minhcore/dry-storage-cabinet/vi_xu_ly.docx

Tủ bảo quản thiết bị linh kiện chuyên dụng (Đặng Phan Nhật Minh-B2405313)

1. Mô tả nguyên lý hoạt động

-Hệ thống tủ bảo quản hoạt động trên nguyên lý ngưng tụ hơi nước. Cảm biến liên tục đo và giám sát độ ẩm bên trong tủ. Khi độ ẩm vượt quá mức cài đặt, hệ thống tự động kích hoạt module làm lạnh để hạ nhiệt độ luồng khí xuống dưới điểm sương. Hơi nước dư thừa sẽ ngưng tụ thành nước lỏng và được dẫn xả ra ngoài, giúp hạ độ ẩm trong tủ. Khi độ ẩm giảm xuống đạt mức an toàn, hệ thống ngắt module làm lạnh và duy trì trạng thái chờ.

2. Phạm vi thực hiện

Phạm vi:

-Giám sát và hiển thị thông số nhiệt độ, độ ẩm liên tục qua màn hình OLED.

-Cho phép người dùng tùy chỉnh ngưỡng độ ẩm thông qua nút xoay.

-Cảnh báo bằng còi và đèn LED khi độ ẩm hoặc nhiệt độ vượt ngưỡng an toàn.

-Tự động điều chỉnh quá trình hút ẩm bằng module làm lạnh.

Giới hạn:

-Không có cơ chế bù ẩm chủ động.

-Hệ thống chỉ kiểm soát độ ẩm ở mức nhất định.

-Không điều chỉnh được nhiệt độ.

-Phụ thuộc hoàn toàn vào nguồn điện adapter.
