minhcore/dry-storage-cabinet/kicad_project/dry_storage_cabinet_kicad.pdf

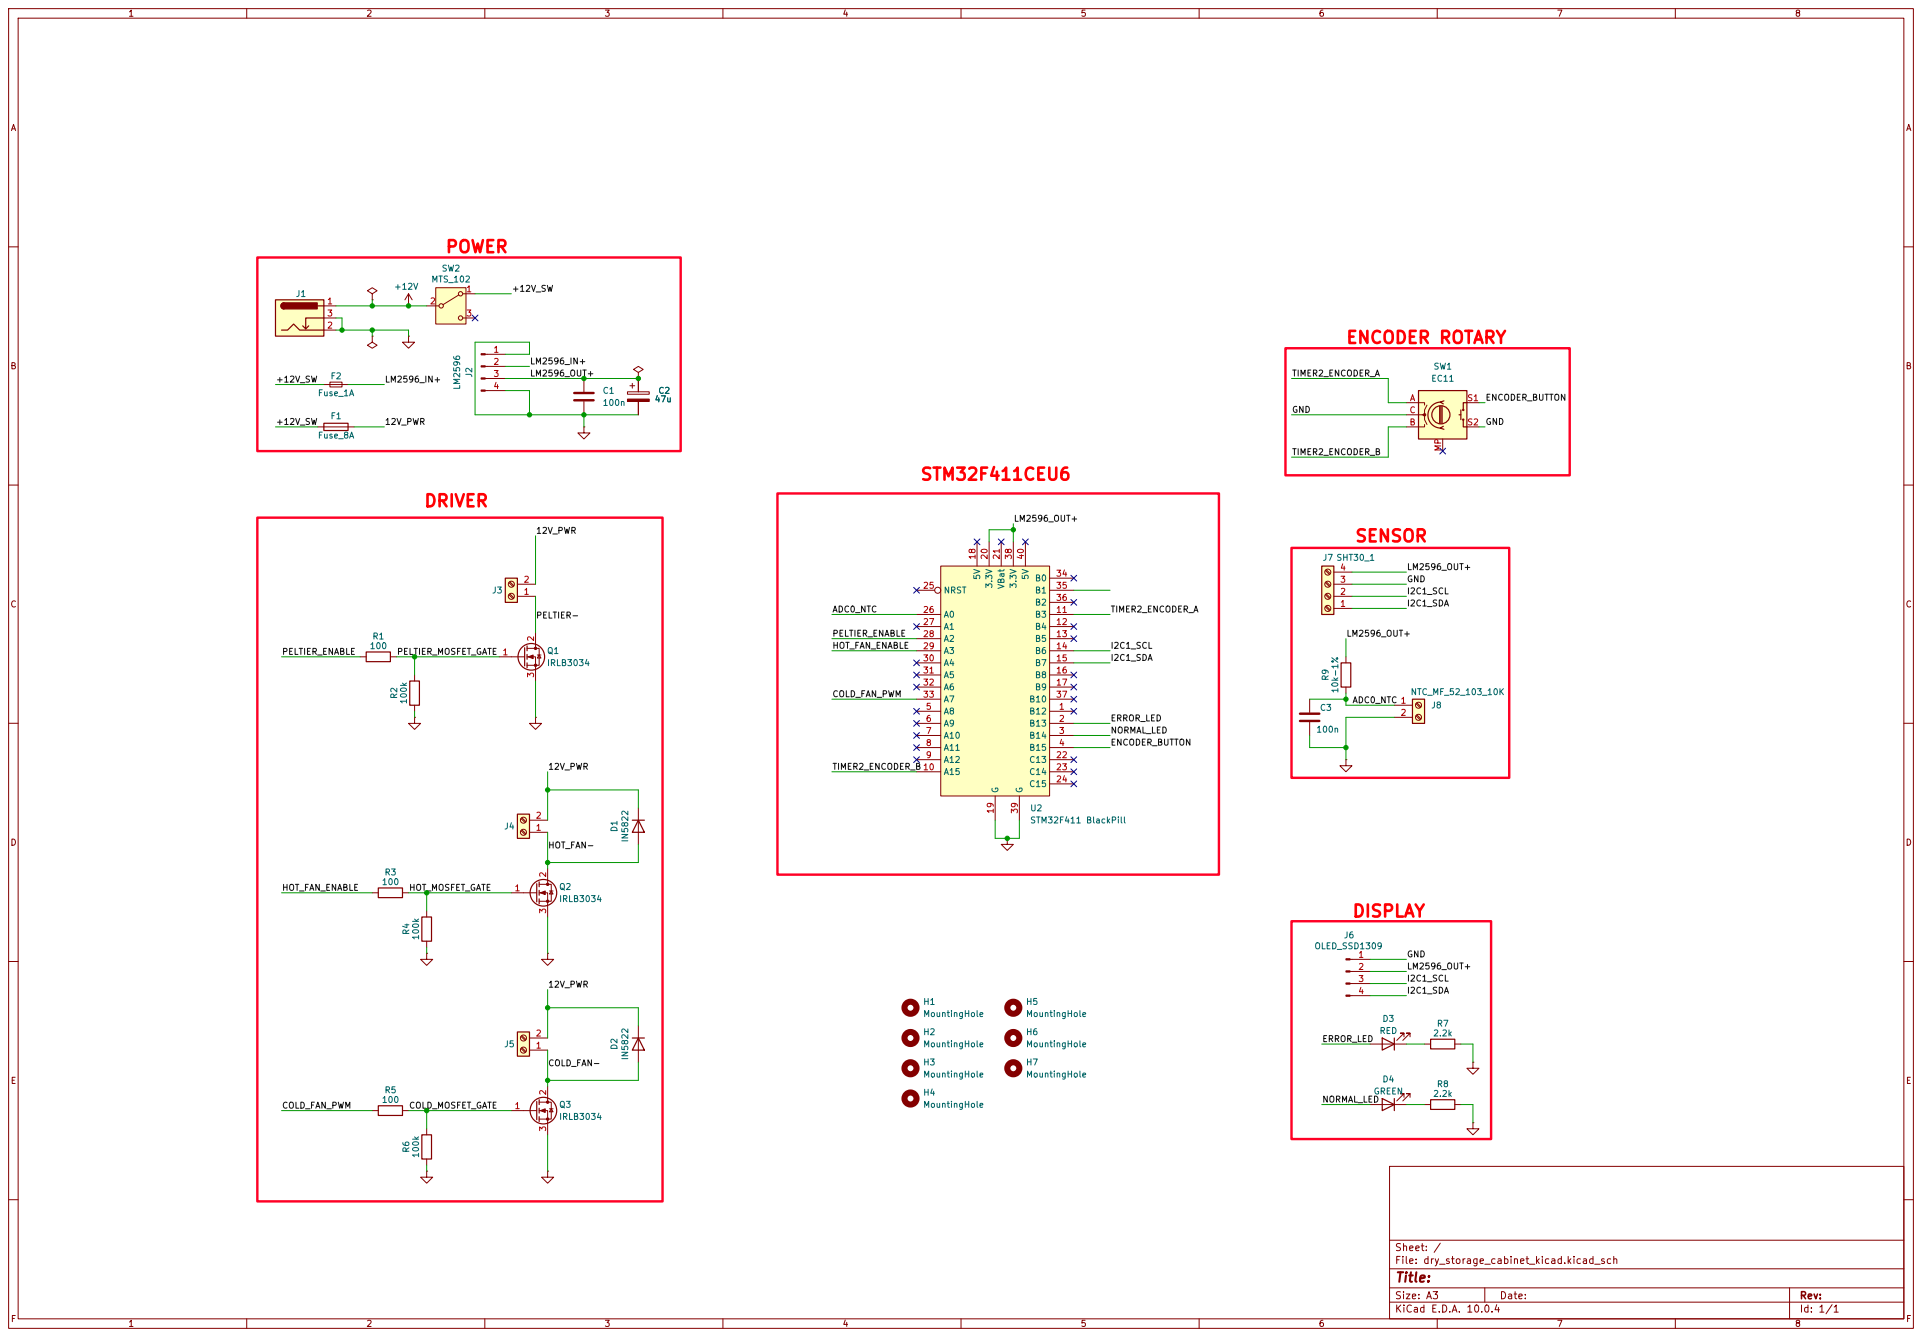
[picture p1: page 1]

Size: A3 | Rev:
KiCad E.D.A. 10.0.4 | Id: 1/1
