minhcore/dry-storage-cabinet/bottom_layer_edge_cut.pdf

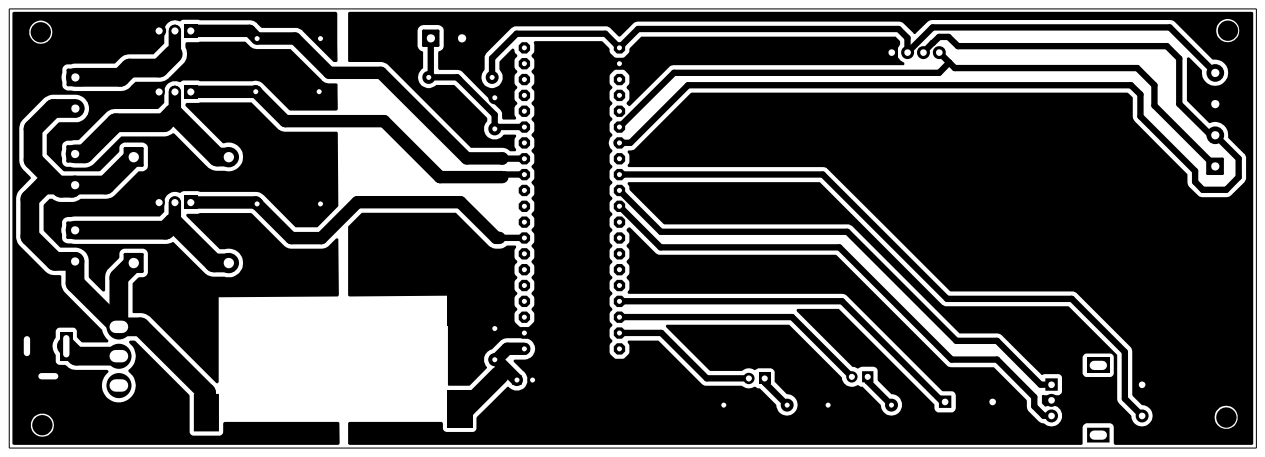
[picture p2: page 1]
