minhcore/dry-storage-cabinet/kicad_project/dry_storage_cabinet_kicad.kicad_pcb

## KiCad design kicad_project/dry_storage_cabinet_kicad.kicad_pcb (2026-07-11)

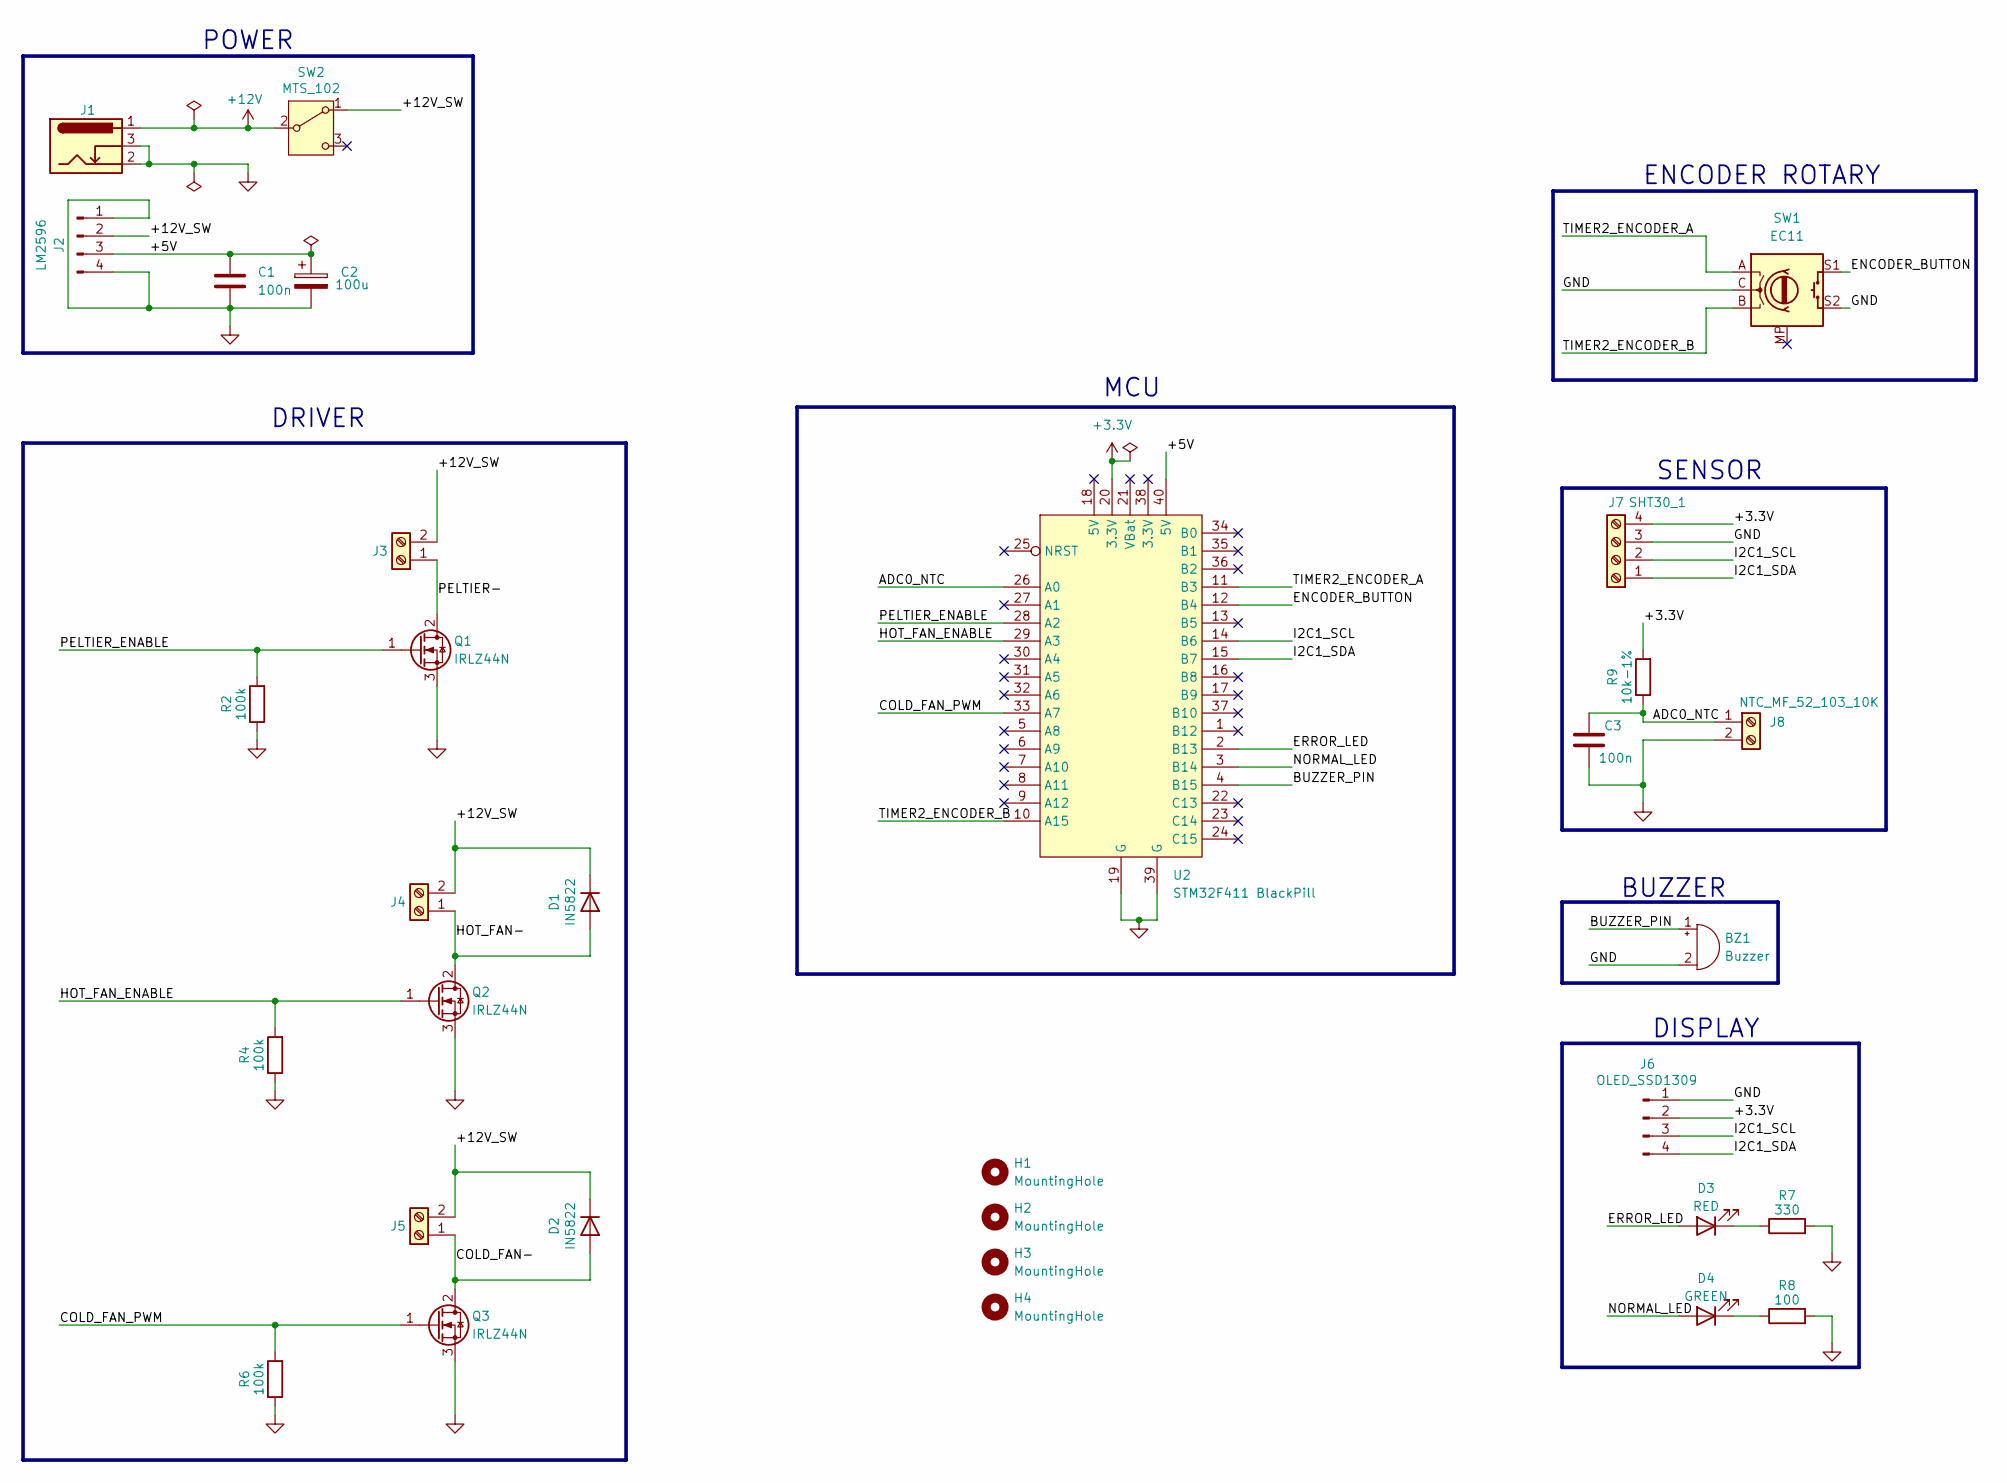
[picture p3: schematic dry_storage_cabinet_kicad.kicad_sch]

Parts:
BZ1: Buzzer; Buzzer_12x9.5RM7.6
C1, C3: 100n; C_Disc_D5.0mm_W2.5mm_P5.00mm
C2: 100u; CP_Radial_D6.3mm_P2.50mm
D1, D2: IN5822; D_DO-201AD_P15.24mm_Horizontal
D3: RED; LED_D3.0mm
D4: GREEN; LED_D3.0mm
H1, H2, H3, H4: MountingHole; MountingHole_3.2mm_M3
J1: Barrel_Jack_Switch; BarrelJack_GCT_DCJ200-10-A_Horizontal
J2: LM2596; LM2596-DC-DC
J3, J4, J5: Screw_Terminal_01x02; TerminalBlock_MaiXu_MX126-5.0-02P_1x02_P5.00mm
J6: OLED_SSD1309; PinHeader_1x04_P2.54mm_Vertical
J7: SHT30_1; TerminalBlock_MaiXu_MX126-5.0-04P_1x04_P5.00mm
J8: NTC_MF_52_103_10K; TerminalBlock_MaiXu_MX126-5.0-02P_1x02_P5.00mm
Q1, Q2, Q3: IRLZ44N; TO-220-3_Vertical
R2, R4, R6: 100k; R_Axial_DIN0207_L6.3mm_D2.5mm_P10.16mm_Horizontal
R7: 330; R_Axial_DIN0207_L6.3mm_D2.5mm_P10.16mm_Horizontal
R8: 100; R_Axial_DIN0207_L6.3mm_D2.5mm_P10.16mm_Horizontal
R9: 10k-1%; R_Axial_DIN0207_L6.3mm_D2.5mm_P10.16mm_Horizontal
SW1: EC11; RotaryEncoder_Alps_EC11E-Switch_Vertical_H20mm_MountingHoles
SW2: MTS_102; MTS102
U2: STM32F411 BlackPill; STM32F411_Black_Pill

Connections:
+3.3V: J6.2, J7.4, R9.2, U2.20 (3.3V)
+12V: J1.1, SW2.2 (B)
/+5V: C1.1, C2.1, J2.3, U2.40 (5V)
/+12V_SW: D1.1 (K), D2.1 (K), J2.2, J3.2, J4.2, J5.2, SW2.1 (A)
/ADC0_NTC: C3.1, J8.1, R9.1, U2.26 (A0)
/BUZZER_PIN: BZ1.1 (+), U2.4 (B15)
/COLD_FAN-: D2.2 (A), J5.1, Q3.2 (D)
/COLD_FAN_PWM: Q3.1 (G), R6.2, U2.33 (A7)
/ENCODER_BUTTON: SW1.S1, U2.12 (B4)
/ERROR_LED: D3.2 (A), U2.2 (B13)
/HOT_FAN-: D1.2 (A), J4.1, Q2.2 (D)
/HOT_FAN_ENABLE: Q2.1 (G), R4.2, U2.29 (A3)
/I2C1_SCL: J6.3, J7.2, U2.14 (B6)
/I2C1_SDA: J6.4, J7.1, U2.15 (B7)
/NORMAL_LED: D4.2 (A), U2.3 (B14)
/PELTIER-: J3.1, Q1.2 (D)
/PELTIER_ENABLE: Q1.1 (G), R2.2, U2.28 (A2)
/TIMER2_ENCODER_A: SW1.A, U2.11 (B3)
/TIMER2_ENCODER_B: SW1.B, U2.10 (A15)
GND: BZ1.2 (-), C1.2, C2.2, C3.2, J1.2, J1.3, J2.1, J2.4, J6.1, J7.3, J8.2, Q1.3 (S), Q2.3 (S), Q3.3 (S), R2.1, R4.1, R6.1, R7.2, R8.2, SW1.C, SW1.S2, U2.19 (G), U2.39 (G)
unnamed: D3.1 (K), R7.1
unnamed: D4.1 (K), R8.1

Notes on the sheet:
BUZZER
DRIVER
ENCODER ROTARY
POWER
DISPLAY
MCU
SENSOR

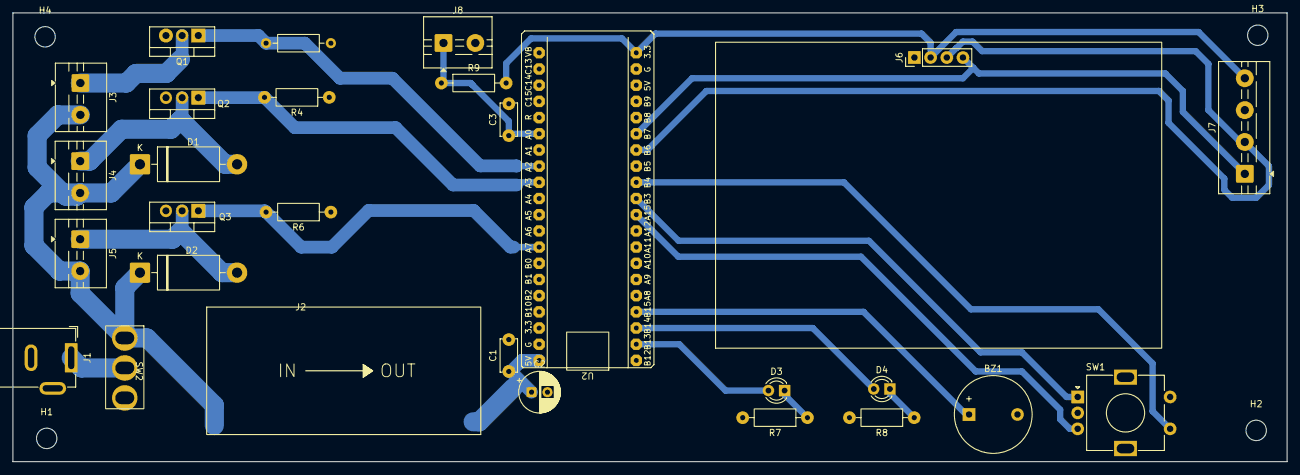
[picture p4: board dry_storage_cabinet_kicad.kicad_pcb from above]

Board: 2 copper layers, 199.9 x 70.4 mm, 32 parts (0 on the bottom side), 22 nets.
