minhcore/dry-storage-cabinet/kicad_project/sht30_pin_to_terminal/sht30_pin_to_terminal.kicad_pcb

## KiCad design kicad_project/sht30_pin_to_terminal/sht30_pin_to_terminal.kicad_pcb (2026-06-30)

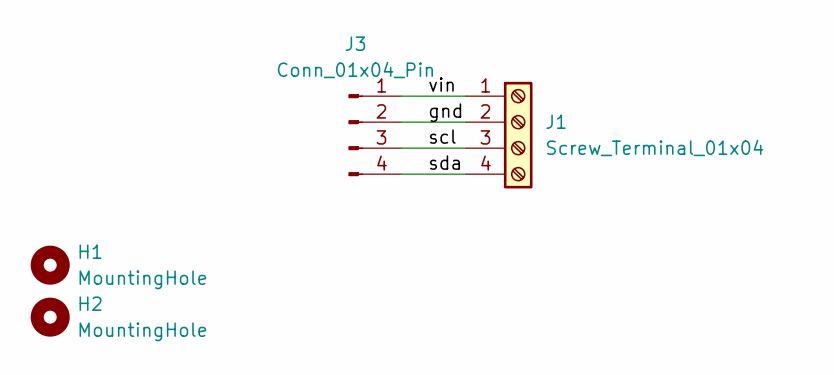
[picture p5: schematic sht30_pin_to_terminal.kicad_sch]

Parts:
H1, H2: MountingHole; MountingHole_3.2mm_M3
J1: Screw_Terminal_01x04; TerminalBlock_MaiXu_MX126-5.0-04P_1x04_P5.00mm
J3: Conn_01x04_Pin; PinHeader_1x04_P2.54mm_Vertical

Connections:
/gnd: J1.2, J3.2
/scl: J1.3, J3.3
/sda: J1.4, J3.4
/vin: J1.1, J3.1

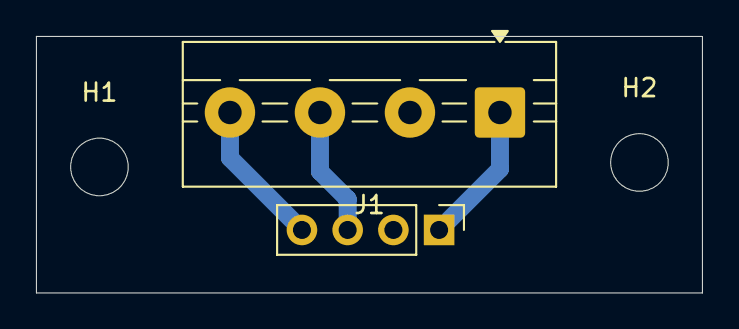
[picture p6: board sht30_pin_to_terminal.kicad_pcb from above]

Board: 2 copper layers, 37.0 x 14.2 mm, 4 parts (0 on the bottom side), 4 nets.
