minhcore/dry-storage-cabinet/stm32f411ceu6_ide_project/Core/Src/main.c

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
/* Includes ------------------------------------------------------------------*/
#include "main.h"

/* USER CODE BEGIN Includes */
#include "oled.h"
#include "sht30.h"
#include "ntc.h"
#include "encoder.h"
#include "control.h"
#include "display.h"
#include "fsm.h"
#include "uart.h"
/* USER CODE END Includes */

/* USER CODE BEGIN PD */
#define STATUS_PORT 				GPIOB
#define ERROR_LED_PIN 				GPIO_PIN_13
#define PELTIER_LED_PIN 			GPIO_PIN_14
#define BUZZER_PIN 					GPIO_PIN_15

#define DRIVER_PORT					GPIOA
#define PELTIER_PIN 				GPIO_PIN_2
#define HOT_FAN_PIN 				GPIO_PIN_3

#define COLD_FAN_TIM_HANDLE			&htim3
#define COLD_FAN_CHANNEL 			TIM_CHANNEL_2

#define ENCODER_BUTTON_PIN			GPIO_PIN_4
#define ENCODER_MAIN_TIM_HANDLE		&htim2
#define ENCODER_TICK_TIM_HANDLE		&htim4

#define MAX_SENSOR_ERROR 			5
#define MAX_DISPLAY_ERROR 			10
/* USER CODE END PD */

ADC_HandleTypeDef hadc1;

I2C_HandleTypeDef hi2c1;

TIM_HandleTypeDef htim2;
TIM_HandleTypeDef htim3;
TIM_HandleTypeDef htim4;

UART_HandleTypeDef huart1;

/* USER CODE BEGIN PV */
oled_t oled = {0};
sht30_t sht30 = {0};
ntc_t ntc = {0};
encoder_t encoder = {0};
control_t control = {0};
volatile event_e event;
state_e current_state;
event_e local_event;
uint8_t sensor_error = 0;
uint8_t display_error = 0;
uint32_t oled_tick = 0;
uint32_t sensor_tick = 0;
uint32_t uart_tick = 0;
uint32_t error_tick, hot_fan_timeout;
sht30_status_e sht30_status;
ntc_status_e ntc_status;
oled_status_e oled_status;
volatile bool error_pending = false;
/* USER CODE END PV */

void SystemClock_Config(void);
static void MX_GPIO_Init(void);
static void MX_ADC1_Init(void);
static void MX_I2C1_Init(void);
static void MX_TIM2_Init(void);
static void MX_TIM3_Init(void);
static void MX_TIM4_Init(void);
static void MX_USART1_UART_Init(void);
/* USER CODE BEGIN 0 */
void HAL_GPIO_EXTI_Callback(uint16_t GPIO_Pin)
{
	if (GPIO_Pin == encoder.button_pin) // Encoder Button is pressed
	{
		if ((HAL_GetTick() - encoder.debounce_tick) >= 200)
		{
			encoder.is_pressed_button = 1;
			encoder.debounce_tick = HAL_GetTick();
		}
	}
}

void HAL_TIM_PeriodElapsedCallback(TIM_HandleTypeDef* htim)
{
	if (htim == &htim4)
	{
		encoder_read(&encoder);
		switch(encoder.status)
		{
		case ENCODER_SCROLL_UP:
			event = UP;
			break;
		case ENCODER_SCROLL_DOWN:
			event = DOWN;
			break;
		case ENCODER_PRESSED:
			event = PRESSED;
			break;
		case ENCODER_NONE:
			break;
		}
	}
}

void menu_setting(void)
{
	switch (current_state)
	{
	case SET_HUM_CHOOSE:
		if (local_event == UP) 	control.target_hum = (control.target_hum == 60) ? 60 : control.target_hum + 1;
		else if (local_event == DOWN) control.target_hum = (control.target_hum == 35) ? 35 : control.target_hum - 1;
		break;
	case SET_ALARM_BUZZER_CHOOSE:
		if (local_event == UP) control.is_buzzer = true;
		else if (local_event == DOWN) control.is_buzzer = false;
		break;
	case SET_ALARM_LIMIT_TEMP_CHOOSE:
		if (local_event == UP) control.temp_limit = (control.temp_limit == 100) ? 100 : control.temp_limit + 1;
		else if (local_event == DOWN) control.temp_limit = (control.temp_limit == 0) ? 0 : control.temp_limit - 1;
		break;
	case SET_ALARM_MARGIN_HUM_CHOOSE:
		if (local_event == UP) control.hum_margin = (control.hum_margin == 10) ? 10 : control.hum_margin + 1;
		else if (local_event == DOWN) control.hum_margin = (control.hum_margin == 0) ? 0 : control.hum_margin - 1;
		break;
	case SET_ALARM_DELAY_HUM_CHOOSE:
		if (local_event == UP) control.hum_delay_mins = (control.hum_delay_mins == 120) ? 120 : control.hum_delay_mins + 5;
		else if (local_event == DOWN) control.hum_delay_mins = (control.hum_delay_mins == 0) ? 0 : control.hum_delay_mins - 5;
		break;
	default: break;
	}
}

void error_raise(void)
{
	if (error_pending) return;

	error_pending = true;
	error_tick = HAL_GetTick();
	hot_fan_timeout = HAL_GetTick();

	// stop all the loads except Hot Fan, leave it to cool down Peltier
	HAL_GPIO_WritePin(DRIVER_PORT, PELTIER_PIN, 0);
	HAL_TIM_PWM_Stop(COLD_FAN_TIM_HANDLE, COLD_FAN_CHANNEL);
	HAL_GPIO_WritePin(STATUS_PORT, BUZZER_PIN, 0);
	HAL_GPIO_WritePin(STATUS_PORT, PELTIER_LED_PIN, 0);
	HAL_GPIO_WritePin(DRIVER_PORT, HOT_FAN_PIN, 1);
}

void error_task(void)
{
	if (!error_pending) return;

	if ((HAL_GetTick() - error_tick) >= 500)
	{
		HAL_GPIO_TogglePin(STATUS_PORT, ERROR_LED_PIN);
		error_tick = HAL_GetTick();
	}

	// After 1 minutes of error happening, turn off Hot Fan
	if ((HAL_GetTick() - hot_fan_timeout) >= 60000) HAL_GPIO_WritePin(DRIVER_PORT, HOT_FAN_PIN, 0);
}

void menu_task(void)
{
	__disable_irq();
	local_event = event;
	event = NONE;
	__enable_irq();

	state_e state_before_event = fsm_get();

	if ((state_before_event == RUNNING) && (local_event == PRESSED) && (control.is_alarm_hum || control.is_alarm_temp))
	{
		control_alarm_ack(&control);
		local_event = NONE; // overwrite if has ALARM
	}

	if (error_pending) local_event = ERROR_HAPPEN; // overwrite if has ERROR

	fsm_run(local_event);
	current_state = fsm_get();
	menu_setting();
}

// Because OLED using i2c interrupt so need this function to call error_raise() task
void HAL_I2C_ErrorCallback(I2C_HandleTypeDef *hi2c)
{
	if (oled.i2c == hi2c)
	{
		display_error++;
		if (display_error >= MAX_DISPLAY_ERROR) error_raise();
	}
}

/* USER CODE END 0 */

/**
  * @brief  The application entry point.
  * @retval int
  */
int main(void)
{

  /* MCU Configuration--------------------------------------------------------*/

  /* Reset of all peripherals, Initializes the Flash interface and the Systick. */
  HAL_Init();

  /* Configure the system clock */
  SystemClock_Config();

  /* Initialize all configured peripherals */
  MX_GPIO_Init();
  MX_ADC1_Init();
  MX_I2C1_Init();
  MX_TIM2_Init();
  MX_TIM3_Init();
  MX_TIM4_Init();
  MX_USART1_UART_Init();
  /* USER CODE BEGIN 2 */

  // OLED
  oled_status = oled_init(&oled, &hi2c1, OLED_ADDR);
  if (oled_status != OLED_OK) error_raise();
  //

  // SHT30
  sht30_status = sht30_init(&sht30, &hi2c1, SHT30_ADDR, sht30_high_repeatability_mode);
  if (sht30_status != SHT30_OK) error_raise();
  //

  // NTC
  ntc_init(&ntc, &hadc1);
  //

  // ENCODER EC11
  encoder_init(&encoder, ENCODER_MAIN_TIM_HANDLE, ENCODER_BUTTON_PIN);
  HAL_TIM_Base_Start_IT(ENCODER_TICK_TIM_HANDLE);
  //

  // POWER DRIVER
  control_init(&control, COLD_FAN_TIM_HANDLE, COLD_FAN_CHANNEL,
		  DRIVER_PORT, PELTIER_PIN, DRIVER_PORT, HOT_FAN_PIN,
		  STATUS_PORT, PELTIER_LED_PIN, STATUS_PORT, BUZZER_PIN);
  //

  // FSM INIT
  fsm_init();
  //

  oled_clear_display(&oled);
  oled_status = oled_send_buffer(&oled);
  if (oled_status != OLED_OK) display_error++;
  /* USER CODE END 2 */

  /* Infinite loop */
  /* USER CODE BEGIN WHILE */
  while (1)
  {
	  menu_task(); // Update current state

	  error_task(); // Handle error

	  if (!error_pending)
	  {
		  control_buzzer_update(&control); // Update buzzer state

		  // Reading sensor values -> Checking alarm and Updating control state
		  if (((HAL_GetTick() - sensor_tick) >= 500) && (HAL_I2C_GetState(sht30.i2c)) == HAL_I2C_STATE_READY)
		  {
			  sht30_status = sht30_get(&sht30);
			  ntc_status = ntc_read_adc(&ntc);

			  if ((sht30_status == SHT30_OK) && (ntc_status == NTC_OK))
			  {
				  sht30_calculate(&sht30);
				  ntc_calculate_temp(&ntc);

				  control_alarm_hum_check(&control, &sht30);
				  control_alarm_temp_check(&control, &sht30);
				  control_update(&control, &ntc, &sht30);

				  sensor_error = 0; // reset sensor error when sht30 and ntc read OK
			  }
			  else
			  {
				  sensor_error++;
				  if (sensor_error >= MAX_SENSOR_ERROR) error_raise();
			  }

			  sensor_tick = HAL_GetTick();
		  }
	  }

	  // Displaying on OLED
	  if ((HAL_GetTick() - oled_tick) >= 250 && (HAL_I2C_GetState(oled.i2c)) == HAL_I2C_STATE_READY)
	  {
		  display_update(current_state, &oled, &sht30, &control);
		  oled_status = oled_send_buffer(&oled);

		  if (oled_status == OLED_OK)
		  {
			  display_error = 0; // reset display error when oled displays OK
		  }
		  else
		  {
			  display_error++;
			  if (display_error >= MAX_DISPLAY_ERROR) error_raise();
		  }

		  oled_tick = HAL_GetTick();
	  }

	  if ((HAL_GetTick() - uart_tick) >= 500)
	  {
		  uart_send_int(HAL_GetTick());
		  uart_send_char(',');
		  uart_send_int(sht30.hum*100);
		  uart_send_char(',');
		  uart_send_int(control.target_hum*100);
		  uart_send_char(',');
		  uart_send_int(control.debug_turn_on*100);
		  uart_send_char(',');
		  uart_send_int(control.debug_turn_off*100);
		  uart_send_char(',');
		  uart_send_int(control.debug_peltier);
		  uart_send_char(',');
		  uart_send_int(control.debug_cold_fan);
		  uart_send_char(',');
		  uart_send_int(ntc.temp*100);
		  uart_send_char(',');
		  uart_send_int(control.debug_dewpoint*100);
		  uart_send_char(',');
		  uart_send_int(control.state_elapsed_ms);
		  uart_send_char(',');
		  uart_send_int(control.debug_profile);
		  uart_send_char(',');
		  uart_send_int(control.debug_condensing_started);
		  uart_send_char(',');
		  uart_send_int(control.debug_fan_boost_allowed);
		  uart_send_char(',');
		  uart_send_int(sht30.temp*100);
		  uart_send_string("\r\n");
		  uart_tick = HAL_GetTick();
	  }
	  /* USER CODE END WHILE */

    /* USER CODE BEGIN 3 */
  }
  /* USER CODE END 3 */
}

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
