minhcore/dry-storage-cabinet/stm32f411ceu6_ide_project/stm32f411ceu6_final_project.ioc

Mcu.UserName=STM32F411CEUx
PA0-WKUP.Signal=ADCx_IN0
PA10.Signal=USART1_RX
PA15.Signal=S_TIM2_CH1_ETR
PA2.Signal=GPIO_Output
PA3.Signal=GPIO_Output
PA7.Signal=S_TIM3_CH2
PA9.Signal=USART1_TX
PB13.Signal=GPIO_Output
PB14.Signal=GPIO_Output
PB15.Signal=GPIO_Output
PB3.Signal=S_TIM2_CH2
PB4.Signal=GPXTI4
PB6.Signal=I2C1_SCL
PB7.Signal=I2C1_SDA
