minhcore/dry-storage-cabinet/stm32f411ceu6_ide_project/Core/Inc/fsm.h

#ifndef FSM_H_
#define FSM_H_

typedef enum
{
	// Main state
	RUNNING,
	ERROR_HANDLE,

	// Menu setting state
	SET_TARGET,
	SET_ALARM,
	MENU_EXIT,

	// Humidity setting state
	SET_HUM_IDLE,
	SET_HUM_CHOOSE,
	SET_HUM_BACK,

	// Set Alarm (MAIN) setting state
	SET_ALARM_TEMP,
	SET_ALARM_HUM,
	SET_ALARM_BUZZER,
	SET_ALARM_BUZZER_CHOOSE,
	SET_ALARM_BACK,
	
	// Set Alarm (SUB) temperature
	SET_ALARM_LIMIT_TEMP,
	SET_ALARM_LIMIT_TEMP_CHOOSE,
	SET_ALARM_TEMP_BACK,

	// Set Alarm (SUB) humidity
	SET_ALARM_MARGIN_HUM,
	SET_ALARM_MARGIN_HUM_CHOOSE,
	SET_ALARM_DELAY_HUM,
	SET_ALARM_DELAY_HUM_CHOOSE,
	SET_ALARM_HUM_BACK

	// ...
} state_e;
typedef enum
{
	UP,
	DOWN,
	PRESSED,
	NONE,
	ERROR_HAPPEN
} event_e;

typedef struct
{
	state_e current_state;
	event_e event;
	state_e next_state;
} transition_t;

void fsm_init(void);
void fsm_run(event_e current_event);
state_e fsm_get(void);

#endif
