minhcore/dry-storage-cabinet/(commit log)

2026-06-23 create basic folder for kicad
    [dry_storage_cabinet_kicad.kicad_pcb, dry_storage_cabinet_kicad.kicad_sch]
2026-06-24 Testing oled driver & encoder driver
2026-06-30 Get ready to testing i2c 20 cm cable
    [sht30_pin_to_terminal.kicad_pcb, sht30_pin_to_terminal.kicad_sch]
2026-07-11 70% hardware, testing now
    [dry_storage_cabinet_kicad.kicad_pcb, dry_storage_cabinet_kicad.kicad_sch]
2026-07-12 all the driver are good, get ready to refractor code
2026-07-12 done the fsm using table method, kinda good, I feel it better than nested switch
2026-07-13 Fixed the smooth of encoder and display, update encoder.c and oled.c
    [display.c, encoder.c, fsm.c, fsm.h, main.c, oled.c, sht30.c, stm32f411ceu6_final_project.ioc]
2026-07-13 Create some menu display and new logic for control humidity using D in PID
2026-08-02 new logic for control Peltier, derivatives is a little bit noisy
    [log_40.csv, log_50.csv, log_50_with_peak_tracking.csv, log_50_with_peak_tracking_learn.csv, log_60.csv]
2026-08-04 still not gud
    [log_35.csv, log_40.csv, log_50.csv, log_50_with_peak_tracking.csv, log_50_with_peak_tracking_learn.csv, log_60.csv]
2026-08-05 update current progress
    [dry_cabinet_log_20260804_211017.csv, log_35_new.csv, log_43_new.csv, log_50_new.csv, log_55_new.csv, log_55_new_new.csv, log_60_new.csv]
2026-08-05 add error display task, refract the code
    [control.c, control.h, display.c, fsm.c, main.c, ntc.c, ntc.h, oled.c]
2026-08-05 wrong typo, change to BUZZER_PIN GPIO_PIN_15
    [main.c]
2026-08-07 fixed some bugs displaying
    [control.c, control.h, display.c, fsm.c, main.c, sht30.c]
2026-08-07 Fixed logic of hum alarm
    [control.c]
2026-08-07 fixed error handle and restruct main loop for better
    [main.c]
2026-08-07 fixed fsm bug (fsm.c)
    [fsm.c, main.c]
